cnlohr/esptracker/README.md

# esptracker
Lighthouse-based tracker using the TS4231
