cnlohr/esptracker/(threads)

Thread 1 (2018-07-22):

Let's try figuring out the data stream.

cnlohr, 2018-07-22:
I've been putting dumps here: https://drive.google.com/drive/folders/1iN0vuhsRMY6tCWZOCC9F4SSBbT9ljmq7?usp=sharing

Histogram (from 100 MHz FX3 data):
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

vvv C Program for analyzing the FX3 dump.
[analyze.txt](https://github.com/cnlohr/esptracker/files/2216752/analyze.txt)

Hints we got from Ben:
```Ben Jackson	LH2.0 reverse engineering. This is going to be amazing
Ben Jackson	I don't like popcorn but I am baking bread
Ben Jackson	50rpm
Ben Jackson	Charles should make a sampling camera to do ultra-high speed photography of repetitive stuff
Ben Jackson	licensees don't know either
Ben Jackson	yes, that's fine
Ben Jackson	the datasheet has the timings
Ben Jackson	yes, for how to configure the chip
Ben Jackson	the config word isn't that interesting. it's just a way to make adjustments to the chip after the fab. so you would need to know lots of internal details to know what the bits do
Ben Jackson	instead of making a bunch of variants of the chip
Ben Jackson	but once you figure out what it should be, the other values aren't that interesting anymore
Ben Jackson	I think there are updates coming, but I don't know if that's in the update
Ben Jackson	FYI @CNLohr that capture doesn't look right to me
Ben Jackson	it's hard to look at raw analog photodiode signals
Ben Jackson	you need an amplified photodiode with more bw
Ben Jackson	@CNLohr that was re the chat
Ben Jackson	@CNLohr how fast is the ESP sampling?
Ben Jackson	did you look at the datasheet? it should tell you the possible BW of what possible input signals it can process
Ben Jackson	you should probably move the base and the sensor farther apart
Ben Jackson	@MobiusHorizons good idea
Ben Jackson	they don't communicate with each other
Ben Jackson	they're blue while spinning up
Ben Jackson	it is easy to block 2.0 without the blinker
Ben Jackson	there's no clock pin
Ben Jackson	@CNLohr are you sure you powered up and configured the sensor properly?
Ben Jackson	that can make it tricky to just measure the output
Ben Jackson	b/c you still need active config
Ben Jackson	you could have glitched it into sleep mode
Ben Jackson	wait, are you reloading the ESP on every run?
Ben Jackson	and each run it tries to configure the already-configured sensor?
Ben Jackson	@CNLohr beep
Ben Jackson	after you configure the sensor it's in a different mode
Ben Jackson	the initialization sequence won't work then
Ben Jackson	don't drive the D/E lines again after config or you will do unpredictable things
Ben Jackson	so power cycle, send config sequence, D/E go hi-Z and stay hi-Z as long as you want to use it
Ben Jackson	if you have to drive those during a reload you should powercycle the sensor
Ben Jackson	that looks about right for config
Ben Jackson	you sure you are loading those bits in the right order?
Ben Jackson	that looks potentially right
Ben Jackson	he changed TS4231s
Ben Jackson	where it the sensor in front of the base?
Ben Jackson	measure the env timings
Ben Jackson	you probalby have a local reflection
Ben Jackson	a shiny bit right near the sensor
Ben Jackson	like a connector
Ben Jackson	no SUPER local
Ben Jackson	like on the board with the sensor
Ben Jackson	or just move the base way farther away
Ben Jackson	yeah black gaffer tape isn't great for IR
Ben Jackson	sharpie is also terrible in ir
Ben Jackson	the first step to blocking IR is to realize your intuition for what color or transparency things are in IR is shit
Ben Jackson	for not reflecting we have some special matte black optical tape that's black in IR
Ben Jackson	and for blocking transmission you really need foil backed tape
Max Bambusman	@Ben Jackson aluminium duct tape?
Ben Jackson	that will definitely block it
Ben Jackson	but then it's a mirror
Ben Jackson	the tape we use has foil lining but it's black on the outside
Ben Jackson	blue painters tape is almost entirely transparent in IR, fyi
Ben Jackson	@Naters305 it's kind of like interviewing 😉
Naters305	Haha Nice @Ben Jackson
Ben Jackson	I'm going to laugh so hard when you figure out what this bitstream is
Ben Jackson	understanding the bits should be straightforward
Ben Jackson	or rather demodulating them
Ben Jackson	but figuring out what they are might be a crueler challenge than the old wireless protocol
Ben Jackson	@Peter S. Hollander email the VR licensing email (include your account name if it's not obvious) and I can send you some
Ben Jackson	What will his chat thing do if 我说汉语
Ben Jackson	it doesn't like emoticons
Ben Jackson	oh cool it beeps
Ben Jackson	this is super handy
Ben Jackson	unicode characters made your terminal beep
Ben Jackson	they stop transmitting when the motor control loop goes out of spec
Ben Jackson	so in theory if you spun the outside at -50rpm very constantly it would work
Ben Jackson	but your outside motor control loop would need to hold about 200ppm tolerance
Ben Jackson	yeah, I never thought about how hard this would be to reverse engineer from snippets
Ben Jackson	interesting idea
Ben Jackson	or point it into an integrating sphere
Ben Jackson	@CNLohr you didn't forget about power cycling if you want to reconfigure, right?
Ben Jackson	you should just power it with a fet so you can toggle it in the boot sequence
Ben Jackson	@MobiusHorizons the shape of a flashlight beam reflector has the properties you want (i.e. it kind of collimates light)
MobiusHorizons	@Ben Jackson that's pretty much what I was thinking
Ben Jackson	what, you don't want to build an integrating sphere?
Ben Jackson	I love the juxtaposition of how clever an idea that is vs how much it will not help you at all :)
Ben Jackson	how much of a hint do you want
Ben Jackson	the wall would work
Ben Jackson	oh, no, the wall will be more useful
Ben Jackson	wall is strictly a good idea and an improvement over short captures
Ben Jackson	and you will easily figure out 1s vs 0s
Ben Jackson	right
Ben Jackson	I mean having a longer sequence of bits won't help you
Ben Jackson	😃 😃 :)
Ben Jackson	so @Peter S. Hollander has decided to start cutting off his leg with the saw ;-)
Max Bambusman	@Ben Jackson how much do you/steam want the vive to be reverse engineered?
Ben Jackson	when I designed it originally I started by capturing with saleae and decoding w/ python
Ben Jackson	it will export to CSV
Ben Jackson	then I wrote a saleae plugin to demodulate which is fun
Ben Jackson	you typo'd 6MHz as 600kHz at some point
Ben Jackson	the saleae protocol decoders are asynchronous and run in another thread
Ben Jackson	so there can be weird latency
Ben Jackson	I've never tried to use the manchester module
Ben Jackson	it probably would want 6Mhz differential manchester
Ben Jackson	you sure that's not decoding?
Ben Jackson	hmm
Ben Jackson	silicone labs
Ben Jackson	hmmmm
Ben Jackson	try differential manchester, 6MHz, one bit per transfer
Ben Jackson	I wonder if that would work
Ben Jackson	I could find a capture and test
Ben Jackson	maybe it wants 3?
Ben Jackson	does it want 12?
Ben Jackson	it does
Ben Jackson	@CNLohr turn off your unused channels to capture
Ben Jackson	time to 也说汉语
pacccer	@Ben Jackson do we need a higher sample rate?
Ben Jackson	@pacccer I just realized when he was exporting that he had all channels on
Ben Jackson	not sure where he captured
Ben Jackson	@Jernej Jakob right
Ben Jackson	note that the laser line comes out perpendicular to the stripes you see on the lens
Ben Jackson	well you can't take it apart because it's impossible to take apart
Ben Jackson	I'm waiting for ifixit to give it a -1 on the servicability scale
Ben Jackson	1004 is the start of all of our model numbers
Ben Jackson	only for management
Ben Jackson	@CNLohr turn off the unused saleae channels
Ben Jackson	that will unlock higher bw options
Ben Jackson	ohhh non-pro
Ben Jackson	turns out you can tell if your supply chain is compromised if FTDI makes their drivers fail on those devices
Ben Jackson	well if FTDI found out that your devices included counterfeit chips they could sue to prevent you from importing them
Ben Jackson	?
Ben Jackson	I don't care about FTDI
Ben Jackson	what was the capture frequency?
Ben Jackson	that's a good choice
Ben Jackson	I feel like you could get something out of 24MHz the way you're capturing
Ben Jackson	one thing to consider: how would you modulate this if you were doing it?
Ben Jackson	does it make sense if 1's are \"long\" and 0's are \"short\"? that's not a constant bitrate
Ben Jackson	sure, but that's partly down to how you analyzed it
Ben Jackson	your analysis method *adds* phase noise
Ben Jackson	because you add in all phase noise in every edge
Ben Jackson	man this is serious deja vu for me
Ben Jackson	you really want some mulitple of 6 or better 12 or your life is going to be even harder
Ben Jackson	I used 500 :)
Ben Jackson	going to have to go soon
Ben Jackson	if you want to request any specific hints before, now's the time
Ben Jackson	I want to see your reaction when you figure it out, but I think it might take a few more streams...
Ben Jackson	your analysis with your eyes just scrolling along was good
Ben Jackson	your question about bit stuffing already includes an incorrect assumption
Ben Jackson	so the answer is \"mu\"
Ben Jackson	yes
Ben Jackson	although it's DC balanced regardless
Ben Jackson	he's right about \"mu\"
Ben Jackson	the bitstream AND the encoding are both dc balanced
Ben Jackson	you kind of asked about one
Ben Jackson	re: bit stuffing
(I was talking about something ABOUT the signal just naturally works out to make it work out to be right)
Ben Jackson	yes
Ben Jackson	YES
Ben Jackson	oh man you're so close :)
Ben Jackson	got to go, catch up with you all later
```

cnlohr, 2018-07-26:
Internal pics of the lighthouse:

https://drive.google.com/drive/folders/1cRZ3P2-qimd7ccLXDEDPEvQxj6XS1rv1?usp=sharing

Some notes: TP5/TP6 was interesting... Seemed to be a square wave having to do with the rotor.

The data file:

We probed TP2 and TP16, and read them in with my $45 FX3 at 100 MHz, here is the file, 16-bit wide samples, only look at the bottom 4 bits.  Basically, you get repeating 16-bit words...  The bottom 4 bits are:

```
LSB  -> The envelope from the TS4231
     1  -> The data line from the TS4231, Lighthouse pointed at TS at about 1.5 feet away.
     2  -> TP2  (DIRECTLY from the lighthouse)
 MSB -> TP16
```

[Data_20180725223508.8.dat.zip](https://github.com/cnlohr/esptracker/files/2230266/Data_20180725223508.8.dat.zip)

https://github.com/cnlohr/esptracker/issues/2

mungewell, 2018-07-27:
In terms of spotting repetition/framing in the data - it might be worth looking at TP2 bit, perform a rolling average (to remove sampling variance and covert to greyscale) and then plot it as various width images.

At some image width(s) the image should (mostly) consist of vertical lines where the sync pattern is.

mungewell, 2018-07-27:
Something like:
[test.py.txt](https://github.com/cnlohr/esptracker/files/2237368/test.py.txt)
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

See some structure  bit1, but not from TP's

cnlohr, 2018-07-28:
What is TP2?  All you should care about is the first bit...

mungewell, 2018-07-28:
Don't know ;-) Plotting more of the data shows sections of 'all 1s' so there is some structure. Maybe the TP2 is serialized multi-bit data?

[test.py.txt](https://github.com/cnlohr/esptracker/files/2238083/test.py.txt)
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

Also had another thought. Whatever the on-beam sync data is, it must be very small/short as the sweeping beam(s) are only on the sensor for a short time. It would be helpful to understand the time info of the sweeps/etc so that we could understand how much the sensor actually sees.

r2x0t, 2018-08-02:
You must have some problem with FX3 streaming, because the recorded file is not continuous. There are jumps in the data stream every 8192 words (= usb transfer size?) Some buffer is overflowing and you are losing data.

Here you can see how the manchester bitstream clock periodically jumps:
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

Try lower speed (50 or 25MHz should be enough to decode this) or improve USB handling (increase number of overlapped buffers waiting at driver level to be filled, add additional buffer or tweak it in some other way).
It's best to test it with signal generator or replace first bytes from each USB frame with counter + timer in fx3, so you can detect any lost frames as well as measure usb latency.

cnlohr, 2018-08-05:
@r2x0t You're right! There are actually a lot of problems with that last data stream.  I re-worked the state machine in the FX3 GPIF and fixed a bug in my USB writer. Now, it should be good, all the time.

https://drive.google.com/file/d/1GsVtNzmJHMdrxVYvbTNRq2tcDHcOnCcJ/view?usp=sharing

Try above data set, @mungewell

r2x0t, 2018-08-05:
@cnlohr It's better, but still there is something happening every 16384 bits and I don't think this is in original signal (again same as USB buffer size):
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
(used differential display to better see the edges)
But looks like it skips either 1-2 samples or multiple of samples in the length of symbol (much less likely). Doing PLL @ 12MHz recovers good looking manchester coded bitstream. Will continue to dig deeper...

cnlohr, 2018-08-05:
@r2x0t Is there any way you can give me your code so we can test against that when I capture the data?  I can still try a few different things within the FX3 GPIF engine to avoid any missing samples.

r2x0t, 2018-08-05:
@cnlohr I'm using tool called ViewBin to analyze and visualize the bitstream. But to get same picture as I posted above, just plot the bits as pixels, nothing special. You can do the same with simple code (take bits, differentiate, plot 210 bits/line).

cnlohr, 2018-08-05:
New data is up: https://drive.google.com/drive/folders/1IDDs67zcUPaqEtRxioHnWZO2vxHtX8Zc

It contains two different base ID channels.

r2x0t, 2018-08-05:
So looking at the bits, I can clearly see data burst for each sweep with long run of "1" bits between. Distance between sweeps is not exactly the same (could be because of FX3 sampling issues?), mean value is 2013642 samples (equals measured sweep rate of 49.6612605 / sec). Here is the graph of distances:
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
Demodulated data, manchester decoded, one block per line (split by detecting first "0" bit after a lot of "1"): http://puu.sh/B9ggJ/ef2bc84312.7z

Each data burst is LFSR generated sequence using 20 bit shift register. Two sequences are used, probably to send another slow data signalling channel over it. Also each lighhouse is probably using different set of LFSR sequences, so they can be independently detected.
This one is using following taps:
x19+x18+x16+x13+x12+x10+x9+x6+x5+x4+x2+1 (D3675 hex)
x19+x16+x11+x10+x5+x3+x2+1  (90C2D hex)

So running LFSR finding program on the file above to detect used LFSR in each burst results in following: http://puu.sh/B9fH0/2493f2c09c.txt
(using Berlekamp-Massey algorithm on block of 300 bits from each burst)

Note that this is not how it's actually received. Receiver knows the sequences it should look for and it simply have a shift register with taps for each sequence. Bits from taps for every LFSR code are XORed together and if you get run of all zeroes that's >20 bits long, code is detected. I can explain this in more detail or post a code for this if it's not clear.

Anyway resulting "slow" bits from entire file based on two different used LFSRs are:
```
 1101100110101010
11111100111100010
01001100110111100
11111011110001110
11111100100000000
11111000011000010
10111110001001100
11001110100001110
01100011100001110
11100110011111110
11111111010011000
11000110010001010
11000011010100010
01001011000100010
01001011011101100
11101000111111110
11110010100000110
00111001001000110
11111111111111111
01101010011111111
01011011111111111
00010111101110000
00010111001101101
01111111111111111
00000010
```
Not sure about coding used here, but arranging it 17 bits/line results in nice column of zeroes, so possibly some 16 bit words? "11111111111111111" might be message start/end synchronization. Also maybe some ECC is used? And no, there is no ASCII text in it, that would be too easy :)

r2x0t, 2018-08-05:
_CHAN_INIT_Data_20180805155528.8.dat use polys 0xD3675,0x90C2D
_CHAN_AFTER_BUTTON_Data_20180805170303.8.dat uses 0xB85F3,0xC058B

Here is quick code to do the manchester demodulation and LFSR detection. You can uncomment printfs at various lines to get different outputs (demodulated bits, one burst per line) or LFSRs correlation results.
Enjoy!
```
#include <stdio.h>

int main(int argc, char **argv, char **env)
{
 if (argc<3) {
  printf("[file] [ch]\n");
  return 0;
 }
 FILE *f = fopen(argv[1],"rb");
 int ch = 0;
 sscanf(argv[2],"%d",&ch);

 unsigned char buf[1024];
 int bitmask = 1<<ch;
 double fil[7] = {0};
 double old = 0;
 int dist = 0;

 int taps[] = {0xD3675,0x90C2D, // 8_seconds_8_bit_fixed_Data_20180805134454.8.dat _CHAN_INIT_Data_20180805155528.8.dat
               0xB85F3,0xC058B, // _CHAN_AFTER_BUTTON_Data_20180805170303.8.dat
              };
 const int numtaps = sizeof(taps)/sizeof(taps[0]);
 int detect[numtaps] = {0};
 unsigned int sh = 0;
 while(1) {
  int n = fread(buf,1,sizeof(buf),f);
  int on = 0;
  if (n<1) break;
  for(int i=0;i<n;i++) {
   double in = (buf[i]&bitmask)?1.0:-1.0;
   // Filter it using simple FIR to get rid of some one-sample glitches around edges
   fil[0]=fil[1];fil[1]=fil[2];fil[2]=fil[3];fil[3]=fil[4];fil[4]=fil[5];fil[5]=in;
   double v=fil[0]*0.0280+fil[1]*0.1597+fil[2]*0.2779+fil[3]*0.3396+fil[4]*0.2779+fil[5]*0.1597+fil[6]*0.0280;
   double diff = v*old;
   old = v;
   dist++;
   if (diff<0 && dist>10) { // 10 = little bit more than one symbol length
    if (dist>100) { // long run of same bits between bursts
     int max = 0;
     int maxat = 0;
     for(int j=0;j<numtaps;j++) {
      //printf("%06X:%08d   ",taps[j],detect[j]); // detailed LFSR report
      if (detect[j]>max) {
       max=detect[j];
       maxat=j;
      }
     }
     printf("found LFSR %06X bit %d",taps[maxat],maxat&1); // print best one to get bits
     printf("\n");
     for(int k=0;k<numtaps;k++) detect[k]=0;
    } else {
     int bit = (v>0)?1:0;
     //printf("%d",bit); // print raw demodulated bits if you want that

     sh=(sh<<1)|bit;
     for(int j=0;j<numtaps;j++) {
      unsigned int b = sh&taps[j];
      b^=b>>16;b^=b>>8;b^=b>>4;b^=b>>2;b^=b>>1;b&=1; // parity
      if (!b) detect[j]++; // count zeroes
     }
    }
    dist=0;
   }
  }
 }
 fclose(f);
 return 0;
}
```

ElectronAsh, 2018-08-06:
r2x0t

This is awesome work, seriously. :o

When you say "slow" data, do you mean that the Lighthouse switches between the two different LFSRs to send that slower data?

How many sweeps would it take for the receiver to detect each LFSR, or is the data rate fast enough that it would only need ONE sweep to hit a sensor?

I would LOVE to write some quick Verilog code to demodulate this in realtime (from a sensor).

I don't have an original HTC Vive though, only a Rift DK1 and DK2, but it would be interesting to see how hard it would be to do the logic for this.

Are you saying that the shift register in the receiver would just be shifting in the data from the sensor constantly, then you would just take the taps, XOR them, then that would reproduce the "slow" data if you detected a run of bits long enough to fill the shift reg and cause "taps XORed == 0" or "taps XORed == 1"?

I'm still trying to get my brain around how many bits each sensor would typically see during a single sweep.

And, how on Earth did you figure this out so quickly? lol
Do you work in encryption by any chance?

I assumed on one of the last streams that the Lighthouses were probably just spitting out a pseudo-random number sequence all the time (a bit like GPS), but I don't know how you figured out the LFSR taps so quickly. Great stuff.

r2x0t, 2018-08-06:
@ElectronAsh

> When you say "slow" data, do you mean that the Lighthouse switches between the two different LFSRs to send that slower data?

Yes, think of it as form of spread spectrum (DSSS) modulation. Very similar to how navigation data are sent over GPS signal. Now sure what the contents are, but could be anything from lighthouse ID to additional calibration parameters.

> How many sweeps would it take for the receiver to detect each LFSR, or is the data rate fast enough that it would only need ONE sweep to hit a sensor?

Now here is the nice part: only very very small part of bitstream is needed for detection. Exactly 2*20 bits of it, so about ~6.666uS. Once detected, you can also calculate timing from start of the sweep with resolution of used modulation (down to one bit step, so ~0.0833uS).

> I would LOVE to write some quick Verilog code to demodulate this in realtime (from a sensor).

You can pretty much follow my code. Sample fast, then lowpass filter it to reduce noise a bit (fixedpoint FIR will do, nothing special) then look for zero crossings (differences) and feed that to shift register with various taps. XOR the taps and add results to another shift registers and when one of these is all zeroes, you got the match.

> I'm still trying to get my brain around how many bits each sensor would typically see during a single sweep.

Probably quite a lot more than what's needed for detection (based on data rate and timing numbers I wrote above). But it's also important to account for possibly overlapping beams. For that you may need more bits to correlate multiple sequences (just like in CDMA).

> And, how on Earth did you figure this out so quickly? lol

I do SIGINT for fun and profit. Don't even have Vive, just seen one of the @cnlohr videos and though this would be a fun signal to look at :)

ElectronAsh, 2018-08-06:
Ahh, SIGINT makes sense. I thought it was something like that. ;)

Also - I only just woke up, and instantly realised my mistake in how the receiver would know which part of the sweep it's at.

It would know simply by which "step" of the LFSR pattern it shifts into the register, and the LFSR from the LH would start again from 1, or from another known value at the start of each rotor sweep.

Only a tiny movement of the sweep would be needed for the receiver to shift in 20+ bits to do the detection, and work out the rotor angle from that, yep?

Exactly how many permutations are there for each LFSR value? I know it's not just 2^20 (1,048,576), but still a finite amount.

What I don't quite get yet is how the receiver knows from that very small number of bits which LFSR poly it's looking at.

Even with knowing the full table of values for each LFSR, surely there would be some overlap of the same values for each of the two polys?

Or, does the LFSR poly only change per rotor revolution, so the slow data is sent at only around 50 Hz?

r2x0t, 2018-08-06:
> Exactly how many permutations are there for each LFSR value? I know it's not just 2^20 (1,048,576), but still a finite amount.

2^(shift_reg_len)-1 so yes, 2^20-1. Data burst is shorter, so code never repeats.

> What I don't quite get yet is how the receiver knows from that very small number of bits which LFSR poly it's looking at.

To just detect poly (without detecting actual position in the code) you only need 2*LFSR_len bits. You load the first half to the shift register and then generate next half, comparing (XORing) it with 2nd received half. This will exactly match only if correct taps are used. If you have more bits, you can do this over longer block to get some resiliency against flipped bits (receive errors). If you generalize it, you end up with algorithm I used in my code: feed all received bits through shift register, try all taps you are looking for and compare result with incoming stream.

> Even with knowing the full table of values for each LFSR, surely there would be some overlap of the same values for each of the two polys?

This depends on taps/polynomials chosen. Obviously you would pick some that are well orthogonal so cross-correlation between them is as low as possible. As in any CDMA system, there is a trade-off between number of codes and cross-correlation between the codes.
And no, keeping list of all bits isn't really needed, that just wastes memory. After you detect the LFSR, you can run the shift register backwards until you reach initial value - and this will give you actual distance from beginning of the code.

> Or, does the LFSR poly only change per rotor revolution, so the slow data is sent at only around 50 Hz?

Exactly, it only changes between sweeps, so entire data burst is always entirely same sequence. That's why I said "slow data" - effective rate is 50bps

ElectronAsh, 2018-08-06:
Ahh, OK. Got it. Thanks. ;)

Yes, changing the LFSR once per rev does make sense. I couldn't see how it would easily differentiate otherwise.

With other sensors being hit, the receiver would be able to do some correlation there as well, so at least it wouldn't always be relying on a decent signal from one sensor.

I'm still wondering about how best to implement this in Verilog, especially the part about matching the poly without storing all the permutation values.

So, would both halves of the longer LFSR have the same taps for each, or would the taps be calculated for the longer (say 40-bit) value?

I guess it wouldn't be too hard to actually run the LFSR backwards after each "ping" is detected, but you could actually just store all the values in a ROM as well. Having said that, it would be quite a large ROM, and wouldn't fit on a typical mid/low-end FPGA. lol

(the largest amount of on-chip memory I have on a dev board is only around 600KB-1MB.)

I'm also wondering about how the LFSR clocking relates to the quoted "6 MHz" or "6 Mbps" data rate (stated by Ben), and the 48 MHz master clock in the LH. (which was stated by somebody on Discord).

Not that it's too important now, as there will be a certain amount of jitter on exactly when the LFSR restarts on each rotor rev anyway, so the data rate itself isn't so important.

The great thing is, the specific timing of the LFSR clock isn't that critical to figuring out the position either, since it's all related to the rotor angle, and how it coincides with the second sweep.

It's intriguing to think about the algorithm used for correlating the two sweep angles, too.

I'm not great with the maths stuff (to say the least), but I can kind of visualise how that would work.

Again though, once it has the angle values for both sweeps, I guess the rest of the algo is pure trig?

I really want to build a LH 2.0 now. lol. I have plenty of lasers (built my own 1 Watt RGB laser, plus a DAC based on the MCP4922, ESP module, and uSD slot), and plenty of spare hard drives to steal the motors from.

I don't yet have any line generating lenses, but it will be a fun project to try.

ElectronAsh, 2018-08-06:
Just re-reading your other replies, and realising the beauty of this system. :p

I'm just realising how the sensor picks up a kind of "moving window" (literally) of the LFSR, and that they essentially get the resolution down to one clock cycle (or bit width). Genius.

Whoever came up with that at HTC / Valve needs a pay rise. lol

I'm assuming that the LFSR in the receiver (for each sensor) would need to "reset" as the first bit of new data arrives at the sensor? That way, it doesn't get confused by bits that are still sat in the LFSR from the previous sweep?

And, that also means that if less than 20 bits are seen at a sensor, it probably just has to throw out that data, and not use it at all?

(I guess you could still capture a smaller number of bits, and have reduced correlation accurary?)

Or, does it ideally need to clock in at least 20 bits to have any meaningful idea of the rotor position?

I wonder what sort of useful info the slow data will be conveying?

I mean, the new Lighthouses don't really have to sync with each-other any more (AFAIK), so I can't see there being a huge amount of info there.

The two main LFSR values (per Lighthouse) probably just correlate directly to the serial number, so perhaps the slow data just contains some of the calibration values?

Sorry, I know I'm rambling, but this is all very interesting.

r2x0t, 2018-08-06:
Slow data from all files so far:
```
#1 = 8_seconds_8_bit_fixed_Data_20180805134454.8
#2 = _CHAN_AFTER_BUTTON_Data_20180805170303.8
#3 = _CHAN_INIT_Data_20180805155528.8

#1                    #2                    #3
000000000000000001    000000000000000001    000000000000000001
00101011000000001     00101011000000001     00101011000000001
01001000000000001     01001000000000001     01001000000000001
11010000100011111     11010000100011111     11010000100011111
11010001100100101     11010001100100101     11010001100100101
00000000000000001     00000000000000001     00000000000000001
1111101----------     11111010100110001     11111010100110001
-----------------     11100011101010011     11100011101010011
00010011001010101     00010011001010101     000100110010-----
00000011000011101     00010011000011101
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

Thread 2 (2018-07-26):

Dev Chat from before the 7-25-18 Stream

outlaw-josiah, 2018-07-26:
[dev_chat_7-25-18.txt](https://github.com/cnlohr/esptracker/files/2229991/dev_chat_7-25-18.txt)
mcd1992  oh looks like you got the F3 goin

vk2zay  This is gonna be interesting...

CNLohr  You guys have me so worried. Every plan we have is being poo pooed.

delta  Another 45min, already 1:48am for me 😀

vk2zay  Ben and I were just thinking about if we could tell you where to drill, so as to get access to test points without ruining the calibration

vk2zay  Meh, I can just send you another one when you destroy it :)

vk2zay  Did I send you EV2s? They modulate the same way, and IIRC they didn't have laser-welded windows?

Ben Jackson  or drill the top with a broad, shallow bit

vk2zay  Guess you could also listen to it with a receiver, maybe a near-field FET probe poked into a hole drilled in the top, off centre so as to miss the antenna

Ben Jackson  like a 1.5" ish forstner bit

vk2zay  All of this won't really help though...

Ben Jackson  depends on whether your goal is an entertaining live stream or a solution to the puzzle

Ben Jackson  failing is probably always more entertaining

Ben Jackson  failing destructively even more so

vk2zay  Indeed, if it is more about the journey than the destination... I can dig that.

Ben Jackson  PLUS if you commit to the teardown tonight, I can probably quit watching and go drink beer w/ alan

vk2zay  Or we can just make an event of it and have a tear-down Beerus

Ben Jackson  if you had the shucker here I'd say do a competing live stream

Ben Jackson  when they're moments from done, hit the button

vk2zay  LOL

vk2zay  I could like stream attacking a base station with the ultrasonic knife by hand, that's always fun.

Ben Jackson  we lost the footpedal for the ultrasonic knife so it was tossed in the move

vk2zay   Nah, not the descaler (I bought a new one), a proper vibraknife

Thread 3 (2018-08-07):

Lighthouse 2.0 Command Dump

cnlohr, 2018-08-07:
Plug it in while it's on.

Just FYI, I said "mode 16" "mode 0"

```
id         View device identification.
reboot     Reboot board.
shutdown   Shutdown; Shuts down the console, too.
isp        Invoke bootloader for ISP.
stats      Toggle statistics dumping.
clear      Clear statistics.
param      Configure parameters.
genealogy  Manage genealogy information.
perf       Simple math performance measurement.
uptime     System uptime.
dump       Toggle rotor data dumping.
step       Test rotor step response.
ram        RAM inspect.
eeprom     EEPROM inspect and modify.
pwmscan    Scan coarse PWM speed control.
pwmcal     Perform coarse PWM calibration.
pwmopt     Perform coarse PWM optimisation search.
pwmgain    Perform coarse/fine PWM gain measurement.
crash      Crash system.
isl58303   Access laser driver registers.
lis2dh     Access accelerometer registers.
auto       Toggle automatic PWM tuning.
autodebug  Toggle automatic PWM tuning debug.
pll        Toggle PLL control.
plldebug   Toggle PLL debug.
freq       Set rotor spin frequency.
factory    Factory test and calibration command.
fpga       FPGA register access.
mode       Set operating configuration number.
motor      Manual motor driver control.
log        Adjust logging settings.
dtm        Send decimal encoded DTM command params (cmd# <RST, Rx, Tx, End>, ch# <0-39>, pkt len <0-255>, pkt type <PRBS9 0>) to Radio for Testing.
dtm_pwr    Adjust DTM power when radio is in idle (reset) mode. Current options are 4, 3, & 0.
serial_dfu Request Bootloader for Radio and Open UART channel for DFU.
nonce      Request a new pairing code for the radio.
radio      Radio sub-command tree.
lhtx> mode 0mode 0
Current mode: 0
usage: mode <0-16>
lhtx> mode 0
timebase.period = 887000
rotor.pwm = 1727
rotor.pll.offset = 221750
lhtx> mode 1
timebase.period = 959000
rotor.pwm = 1909
rotor.pll.offset = 239750
lhtx> mode 2
timebase.period = 957000
rotor.pwm = 1909
rotor.pll.offset = 239250
lhtx> mode 3
timebase.period = 953000
rotor.pwm = 1909
rotor.pll.offset = 238250
lhtx> mode 4
timebase.period = 949000
rotor.pwm = 1909
rotor.pll.offset = 237250
lhtx> mode 5
timebase.period = 947000
rotor.pwm = 1909
rotor.pll.offset = 236750
lhtx> mode 6
timebase.period = 943000
rotor.pwm = 1909
rotor.pll.offset = 235750
lhtx> mode 7
timebase.period = 941000
rotor.pwm = 1863
rotor.pll.offset = 235250
lhtx> mode 8
timebase.period = 939000
rotor.pwm = 1863
rotor.pll.offset = 234750
lhtx> mode 9
timebase.period = 937000
rotor.pwm = 1863
rotor.pll.offset = 234250
lhtx> mode 10
timebase.period = 929000
rotor.pwm = 1863
rotor.pll.offset = 232250
lhtx> mode 11
timebase.period = 919000
rotor.pwm = 1818
rotor.pll.offset = 229750
lhtx> mode 12
timebase.period = 911000
rotor.pwm = 1818
rotor.pll.offset = 227750
lhtx> mode 13
timebase.period = 907000
rotor.pwm = 1818
rotor.pll.offset = 226750
lhtx> mode 14
timebase.period = 901000
rotor.pwm = 1772
rotor.pll.offset = 225250
lhtx> mode 15
timebase.period = 893000
rotor.pwm = 1772
rotor.pll.offset = 223250
lhtx> mode 16
timebase.period = 887000
rotor.pwm = 1727
rotor.pll.offset = 221750
lhtx> mode 0
timebase.period = 887000
rotor.pwm = 1727
rotor.pll.offset = 221750
lhtx> id
Device Name: DEFAULT
Serial Number: 92D18FD0
Firmware Build: 0.1.8138615 2018-01-18 04:07:10 <buildsystem@fw-keil5-win32>
Radio Build: FW 1.1.6277248	HW 0.0, 3277mV	<buildsystem>
FPGA Code Version: 6
OOTX Model: 14
lhtx> param
usage:
	param list [pattern]
	param info <name>
	param get <name>
	param set <name> <value>
	param default <name>
	param default-all
	param part
	param erase <partition>
	param raw <r|w> <addr>
	param load [partition]
	param save [[partition] [version]]
lhtx> param list
sys.param_magic 1634492787
sys.name DEFAULT
sys.warnings false
sys.emission_enable true *
sys.uptime 571
sys.standby false
sys.identify false
sys.faults 0
sys.config 0
timebase.debug false
timebase.mode master-async
timebase.period 887000
timebase.offset 0
timebase.p 0.050000
timebase.i 0.000000
timebase.d 1.000000
timebase.k 0.999000
timebase.locked true *
timebase.source internal
timebase.current 887000
timebase.tolerance 400 *
timebase.tdm false
timebase.output true
carrier.enable true
carrier.debug false
carrier.cw false
carrier.divider 2
carrier.poly.0 79696
carrier.poly.1 117645
carrier.poly.f 102375
laser.enable true
laser.debug false
laser.interlock true *
laser.fullspin false
laser.phase.on 10.000000
laser.phase.off 350.000000
laser.bias 0
laser.current 123
laser.pwr 70.000000
laser.pwr.debug false
laser.pwr.b1 1.825058
laser.pwr.b2 -8.311882
laser.pwr.m 0.212129
laser.pwr.gain 3
laser.pwr.k1 0.950000
laser.pwr.detected 371.262238
laser.pwr.average 70.056595
laser.apc true
laser.apc.debug false
laser.apc.i 0.010000
rotor.enable true
rotor.debug false
rotor.status fine
rotor.pwm 1661
rotor.pwm.m -0.022000
rotor.pwm.b 92.000000
rotor.pwm.rt 0.000000
rotor.pwm.auto true
rotor.pwm.i 0.001000
rotor.pwm.int 1660.958252 *
rotor.pwm.fine 1918 *
rotor.pll.enable true
rotor.pll.debug false
rotor.pll.p 0.100000
rotor.pll.i 0.010000
rotor.pll.d 0.400000
rotor.pll.s 0.901917 *
rotor.pll.offset 221750
rotor.pll.jitter 300.000000
rotor.pll.phase 1000
rotor.pll.settle 30
rotor.autoclear true
stats.enable false
stats.interval 1
ootx.enable false
ootx.debug false
ootx.lock_required true
ootx.model_override 0
ootx.nonce 62877
accel.enable true
accel.debug false
accel.b1 0.970000
accel.x 0.280412
accel.y 9.340630
accel.z 0.500193
accel.magnitude 9.358238
accel.is_gravity true
accel.dir_x 3
accel.dir_y 127
accel.dir_z 6
accel.temp 40.000000
led.enable true *
led.r 255
led.g 255
led.b 255
led.w 255
fcal.0.tilt -0.045986
fcal.0.phase 0.000000
fcal.0.curve 0.011129
fcal.0.gibphase 2.807692
fcal.0.gibmag -0.004365
fcal.0.ogeephase 0.712315
fcal.0.ogeemag -0.292590
fcal.1.tilt 0.047451
fcal.1.phase -0.002430
fcal.1.curve 0.501718
fcal.1.gibphase 0.182767
fcal.1.gibmag 0.002670
fcal.1.ogeephase 1.181657
fcal.1.ogeemag -0.308045
log.srcs_en 0
log.level Debug
lhtx> genealogy
The command 'genealogy' takes at least 1 argument.
lhtx> perf
overhead: 1.167 us
integer addition: 0.125 us (8000000.0 Hz)
integer multiplication: 0.125 us (8000000.0 Hz)
integer division: 12.630 us (79177.0 Hz)
integer modulo: 12.646 us (79074.1 Hz)
float addition: 2.745 us (364350.6 Hz)
float multiplication: 2.167 us (461538.5 Hz)
float multiply-accumulate: 4.255 us (235022.5 Hz)
float division: 9.212 us (108555.1 Hz)
float fmodf(): 6.868 us (145613.3 Hz)
float sqrtf(): 11.459 us (87271.4 Hz)
float sinf(): 40.041 us (24974.1 Hz)
float asinf(): 35.214 us (28397.9 Hz)
float cosf(): 38.172 us (26197.0 Hz)
float acosf(): 36.292 us (27554.2 Hz)
float tanf(): 50.228 us (19909.3 Hz)
float atan2f(): 51.522 us (19409.2 Hz)
double addition: 8.421 us (118749.9 Hz)
double multiplication: 23.328 us (42867.8 Hz)
double multiply-accumulate: 28.196 us (35465.4 Hz)
double division: 35.861 us (27885.7 Hz)
double fmod(): 13.020 us (76803.7 Hz)
double sqrt(): 84.350 us (11855.4 Hz)
double sin(): 334.632 us (2988.4 Hz)
double asin(): 526.499 us (1899.3 Hz)
double cos(): 332.948 us (3003.5 Hz)
double acos(): 390.290 us (2562.2 Hz)
double tan(): 655.938 us (1524.5 Hz)
double atan2(): 498.148 us (2007.4 Hz)
lhtx> geneaology 1
No such command 'geneaology'.
lhtx> geneology 1
No such command 'geneology'.
lhtx> freq
Rotor Frequency: 54.1150 Hz
lhtx>
```
```

BenWoodford, 2018-08-07:
Worth nothing on the mode thing here, 0 uses the values of the last mode it was set to for some reason - hence the values are the same.

I know, I know. It starts at 1 not 0. It bothers me too.

jjakob, 2018-08-07:
CARRIER_POLYNOMIALS[0]: 0x00013750
CARRIER_POLYNOMIALS[1]: 0x0001CB8D

It looks like these are the LFSR polynomials.  The hint was here all along. :)

jjakob, 2018-08-07:
CARRIER_POLYNOMIALS[0]: 0x00013750
CARRIER_POLYNOMIALS[1]: 0x0001CB8D

It looks like these are the LFSR polynomials.  The hint was here all along. :)

r2x0t, 2018-08-07:
```

OOTX_BUFFER:
00000000: 00 00 4A C0 29 00 1D 08 FE 8C 94 00 03 F5 31 E3  ..J.).........1.
00000010: A9 89 95 45 83 B6 64 30 43 88 23 FC 1A 7A 83 B3  ...E..d0C.#..z..
00000020: 31 78 CE 3C 46 7F E0 16 73 9B A9 E5 76 D3 BB 69  1x.<F...s...v..i
00000030: 3B F5 00 A4 8D DC 2C 60 00 00 00 00 00 00 00 00  ;.....,`........
00000040: 00 00 00 00 00 00 00 00 00 00 00 00 00 00 00 00  ................
00000050: 00 00 00 00 00 00 00 00 00 00 00 00 00 00 00 00  ................
00000060: 00 00 00 00 00 00 00 00 00 00 00 00 00 00 00 00  ................
00000070: 00 00 00 00 00 00 00 00 00 00 00 00 00 00 00 00  ...............

```
This buffer is matching slow data decoded off signal:
```
000000000000000001
00101011000000001
01001000000000001
etc..
```

So this confirms my LFSR detection program decodes it correctly.

The polynomials in configuration aren't the same, this might be because of different design of LFSR generator (there are multiple ways how to do generate it).

r2x0t, 2018-08-07:
OOTX slow data, bytes (stripped 17th bit from each word):
```
2B 00 48 00 D0 8F D1 92 00 00 FA 98 E3 A9 13 2A 16 0E B3 21 04 38 04 7F 06
            ^^^^^^^^^^^                         ~~                ~~
            Device SN                           ??                ??
            0x92D18FD0

9E 41 D9 31 78 9C 78 19 FF 00 B3 39 BA 3C AE B4 EE B4 9D F5 00 49 1B 70 B1
                        ~~                            ^^^^^    ~~~~~~~~~~~
                        ??                          ootx.nonce    CRC32?
                                                      62877
```

Only few bytes are changing (marked "??" above), most is static across even different lighhouses. But found the ootx.nonce and device SN values. I tried interpreting these bytes as float values (and doubles), but no good matches with any of the parameters listed.

cnlohr, 2018-08-07:
Just making sure this is with the newest data set?  @r2x0t  should I record a few more for you?  How long in seconds would we need?  I won't be able to record any more for about a week after today.

Spongman, 2018-08-07:
```
carrier.poly.0 79696
carrier.poly.1 117645
carrier.poly.f 102375
```

maybe you can change them to something boring and expose the real data?

cnlohr, 2018-08-07:
@Spongman  we're kind of to the point where the polynomial isn't stopping us thanks to root's sleuthing. But, these do serve to validate the final polynomial decoding.  It's actually not that bad to determine the OOTX 1's and 0's now.

r2x0t, 2018-08-08:
@cnlohr Because the OOTX_BUFFER can be dumped using console, there is really no need to make a new recordings - we already know how to decode the signal down to same buffer bytes. Just make various configuration changes or hardware changes that might be sent over the air and dump the buffer bytes every time.

jdavidberger, 2019-07-05:
Worth noting that setting mode changes the carrier polynomial, and I get the same polynomials as charles when I set the same mode he had set -- which means we effectively know all currently used polynomials; plus or minus figuring out the exact representation used for them here.
