cnlohr/esptracker/esp12f_base/esp12f_base.kicad_pcb

## KiCad design esp12f_base/esp12f_base.kicad_pcb (2018-04-11)

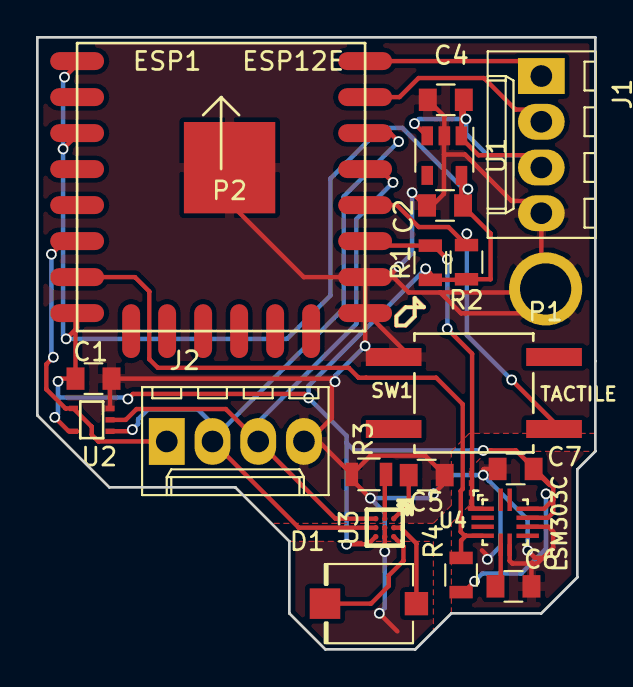
[picture p1: board esp12f_base.kicad_pcb from above]

Board: 2 copper layers, 31.0 x 34.0 mm, 21 parts (0 on the bottom side), 16 nets.

Parts:
C1, C6, C7: .1u; C_0805
C2: 10u; C_0805
C4, C5: 1u; C_0805
D1: VBPW34FASR
ESP1: ESP12E
J1: PGM; Molex_KK-6410-04_04x2.54mm_Straight
J2: MON; Molex_KK-6410-04_04x2.54mm_Straight
P1, P2: CONN_1; SMTPIN
R1, R2, R4: 4k7; R_0805
R3: 15k; R_0805
SW1: TACTILE; TACTILE10
U1: 3.6V Regulator; SOT-23-5
U2: XOR_SOT_353_74LVC1G86; SOT-353
U3: TS4231
U4: LSM303C; 12LGA

Connections:
+3V3: C1.1, C2.1, C7.1, ESP1.1, ESP1.3, ESP1.8, R1.1, R2.1, R4.2, U1.5, U2.5, U3.C3, U4.9, U4.10
+5V: C4.1, J1.3, U1.1, U1.3
GND: C1.2, C2.2, C4.2, C5.1, C6.2, C7.2, ESP1.15, ESP1.16, J1.4, J2.4, P1.1, P2.1, R3.2, SW1.4, U1.2, U2.3, U3.B2, U3.B3, U4.6, U4.8
I2SI: ESP1.6, J2.1, U2.4
IIN+: D1.2, U3.A2
IIN-: D1.1, U3.A3
unnamed: C5.2, U3.A1
unnamed: C6.1, U4.5
unnamed: ESP1.18, R2.2, SW1.1
unnamed: R3.1, U3.B1
RAWDAT: ESP1.19, J2.3, U2.2, U3.C1
RAWENV: ESP1.20, J2.2, U2.1, U3.C2
RXD: ESP1.21, J1.2
SCL: ESP1.17, R1.2, U4.1
SDA: ESP1.7, R4.1, U4.4
TXD: ESP1.22, J1.1
