cnlohr/esptracker/esp8266_gen2/user/i2sduplex.h

//Copyright 2016 <>< Charles Lohr, See LICENSE file.

#ifndef _I2SDUPLEX_TEST
#define _I2SDUPLEX_TEST


//Stuff that should be for the header:

#include <c_types.h>

#define DMABUFFERDEPTH 6
#define I2SDMABUFLEN (128)  //Warning: Making this much smaller can OCCASIONALLY result in missing packets.
#define LINE32LEN I2SDMABUFLEN
#define RX_NUM (I2SDMABUFLEN)

extern uint32_t i2sBDRX[I2SDMABUFLEN*DMABUFFERDEPTH];

extern int fxcycle;
extern int erx, etx;

void ICACHE_FLASH_ATTR testi2s_init();

#endif
