cnlohr/esptracker/(commit log)

2018-04-11 Add ESP12F base
    [esp12f_base-B.Cu.gbl, esp12f_base-B.Mask.gbs, esp12f_base-B.SilkS.gbo, esp12f_base-Edge.Cuts.gm1, esp12f_base-F.Cu.gtl, esp12f_base-F.Mask.gts, esp12f_base-F.Paste.gtp, esp12f_base-F.SilkS.gto]
2018-04-21 Update gen2
    [user.cfg]
2018-04-22 Bump versions - try to track.
2018-04-25 bump to fix misalignment
    [lighthouse_decode.c, lighthouse_decode.h]
