cnlohr/esptracker/(notices)

Notices in the files:
esp12f_base/esp12f_base.kicad_pcb:
(C) 2018 C. Lohr
